jmgao/passinglink/README.md

Moved to [passinglink/passinglink](https://github.com/passinglink/passinglink)
