jmgao/passinglink/pcb/module/passinglink.kicad_pcb

## KiCad design pcb/module/passinglink.kicad_pcb (2019-11-01)

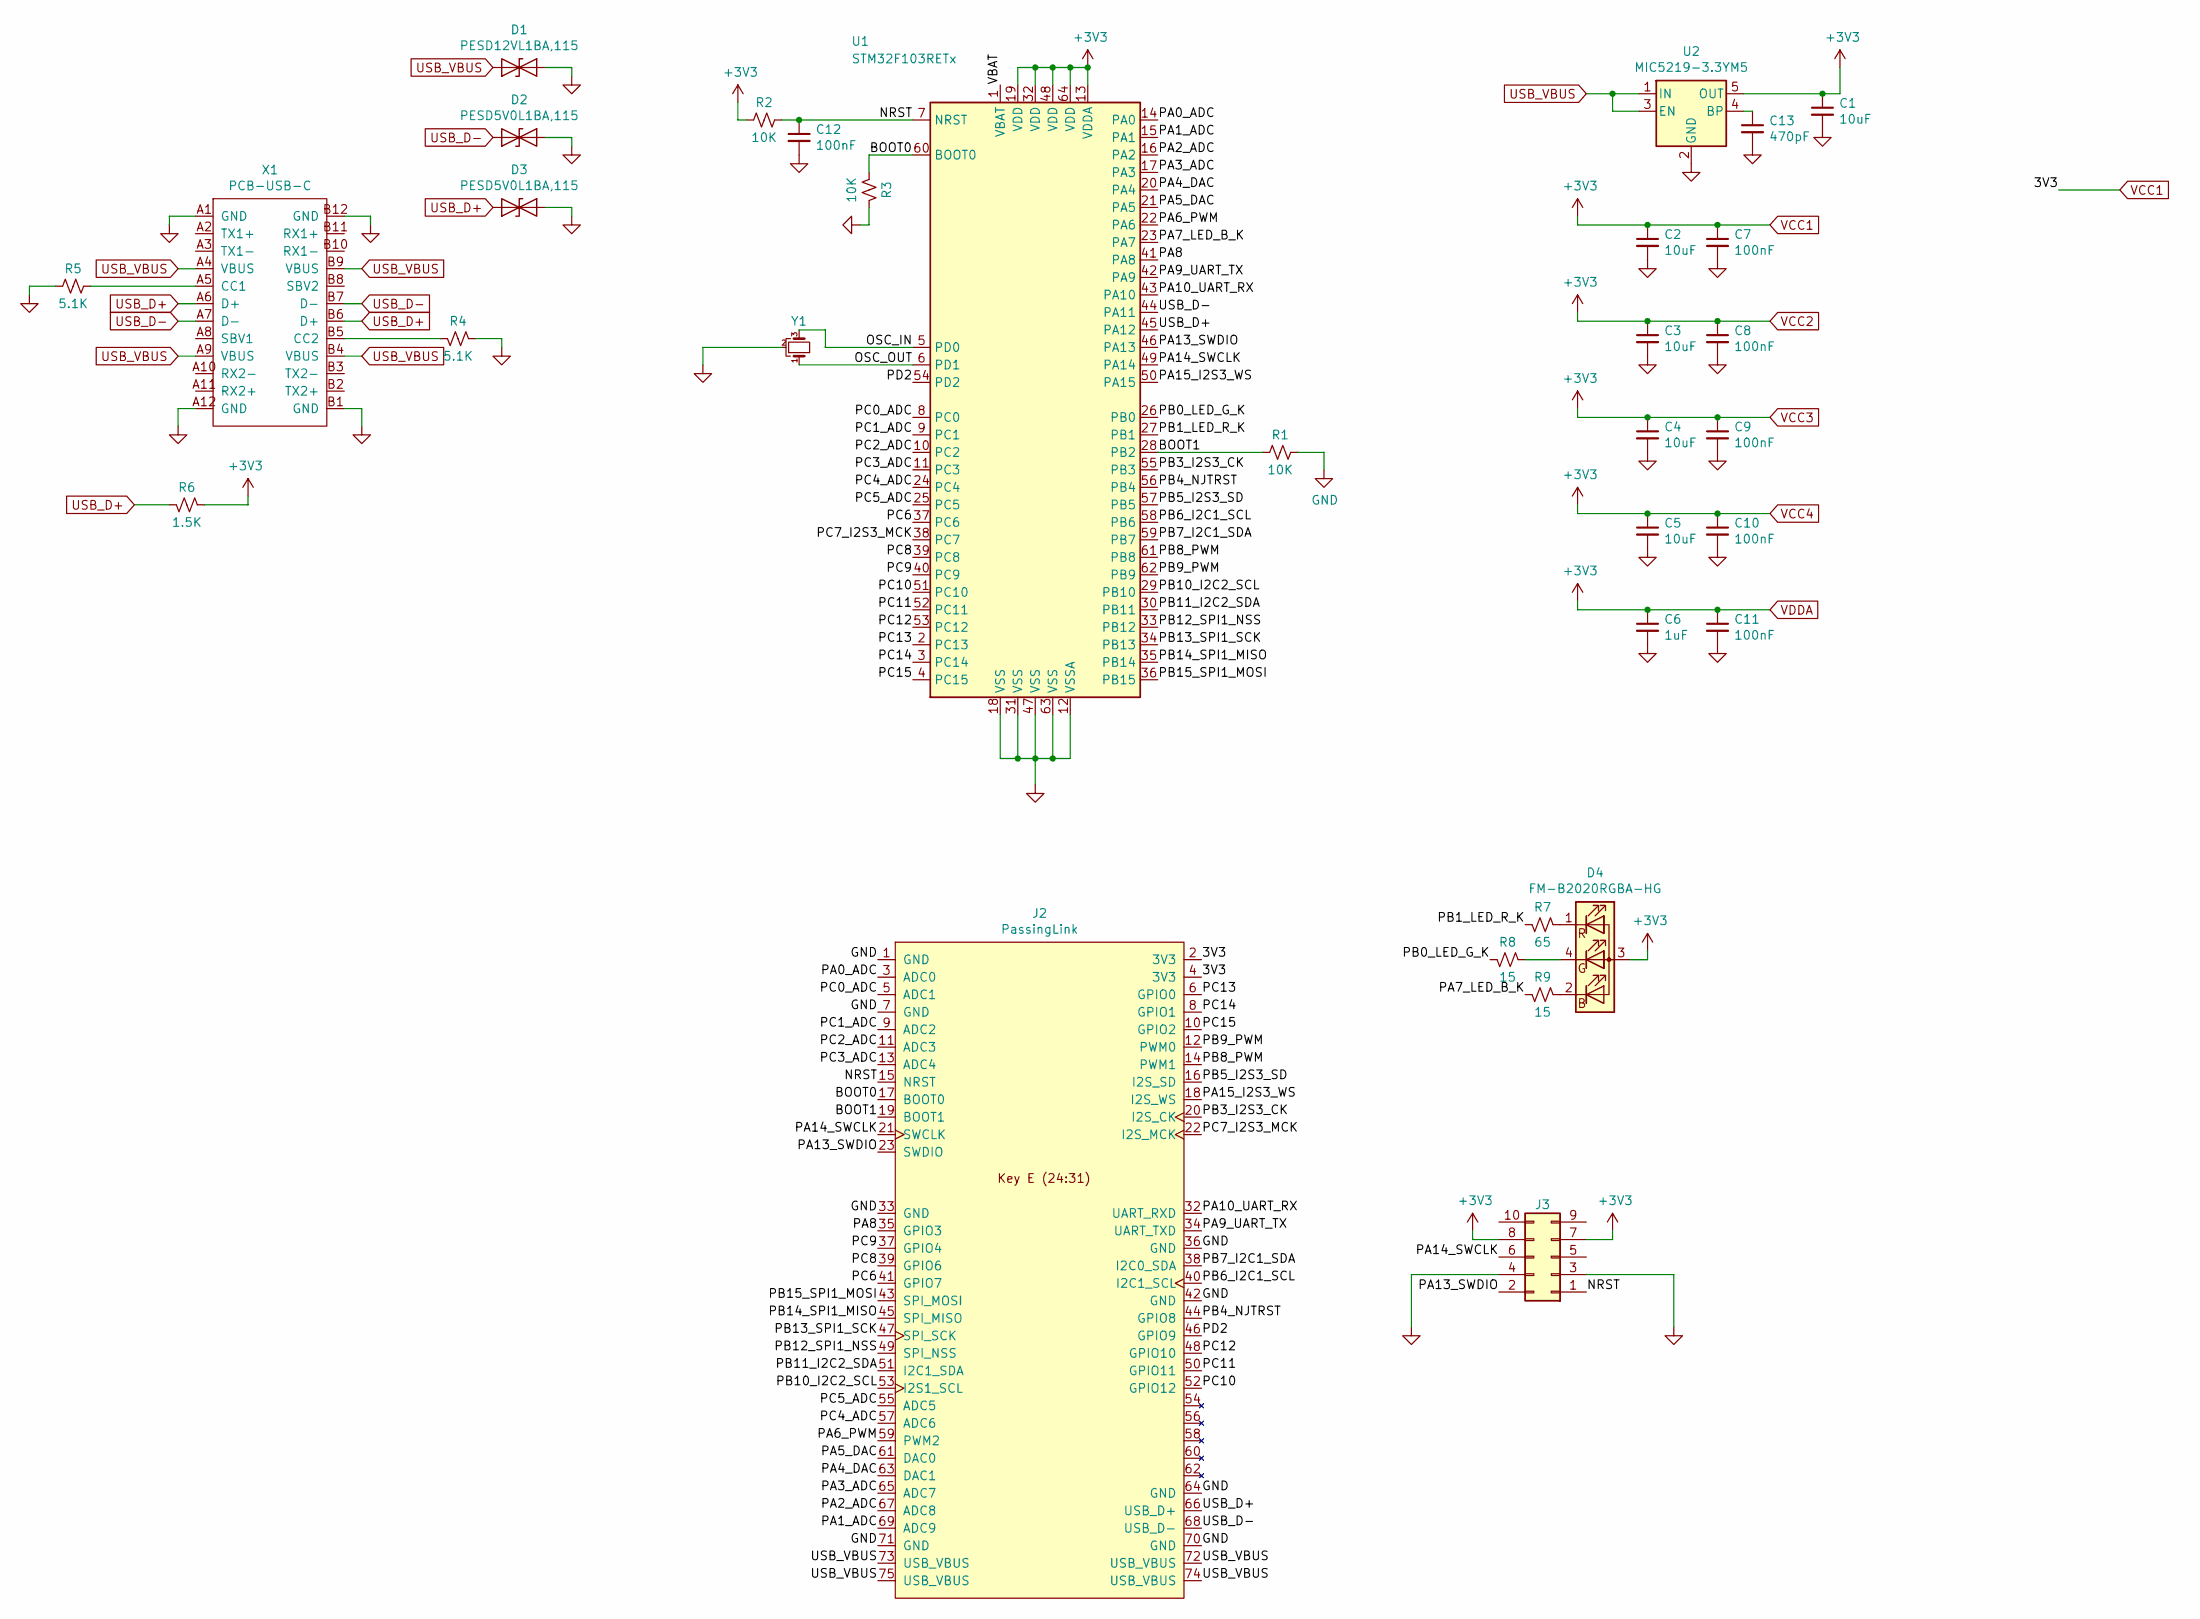
[picture p1: schematic passinglink.sch]

Parts:
C1, C2, C3, C4, C5: 10uF; C_0603_1608Metric
C6: 1uF; C_0603_1608Metric
C7, C8, C9, C10, C11, C12: 100nF; C_0603_1608Metric
C13: 470pF; C_0603_1608Metric
D1: PESD12VL1BA,115; D_SOD-323
D2, D3: PESD5V0L1BA,115; D_SOD-323
D4: FM-B2020RGBA-HG
J2: PassingLink; NGFF_E
J3: Conn_02x05_Odd_Even; Tag-Connect_TC2050-IDC-NL_2x05_P1.27mm_Vertical
R1, R2, R3: 10K; R_0603_1608Metric
R4, R5: 5.1K; R_0603_1608Metric
R6: 1.5K; R_0603_1608Metric
R7: 65; R_0603_1608Metric
R8, R9: 15; R_0603_1608Metric
U1: STM32F103RETx; LQFP-64_10x10mm_P0.5mm
U2: MIC5219-3.3YM5; SOT-23-5
X1: PCB-USB-C
Y1: Crystal_GND2_Small; Resonator_SMD_muRata_CSTxExxV-3Pin_3.0x1.1mm

Connections:
/BOOT0: J2.17 (BOOT0), R3.1, U1.60 (BOOT0)
/BOOT1: J2.19 (BOOT1), R1.2, U1.28 (PB2)
/NRST: C12.1, J2.15 (NRST), J3.1, R2.1, U1.7 (NRST)
/OSC_IN: U1.5 (PD0), Y1.3
/OSC_OUT: U1.6 (PD1), Y1.1
/PA0_ADC: J2.3 (ADC0), U1.14 (PA0)
/PA1_ADC: J2.69 (ADC9), U1.15 (PA1)
/PA2_ADC: J2.67 (ADC8), U1.16 (PA2)
/PA3_ADC: J2.65 (ADC7), U1.17 (PA3)
/PA4_DAC: J2.63 (DAC1), U1.20 (PA4)
/PA5_DAC: J2.61 (DAC0), U1.21 (PA5)
/PA6_PWM: J2.59 (PWM2), U1.22 (PA6)
/PA7_LED_B_K: R9.1, U1.23 (PA7)
/PA8: J2.35 (GPIO3), U1.41 (PA8)
/PA9_UART_TX: J2.34 (UART_TXD), U1.42 (PA9)
/PA10_UART_RX: J2.32 (UART_RXD), U1.43 (PA10)
/PA13_SWDIO: J2.23 (SWDIO), J3.2, U1.46 (PA13)
/PA14_SWCLK: J2.21 (SWCLK), J3.6, U1.49 (PA14)
/PA15_I2S3_WS: J2.18 (I2S_WS), U1.50 (PA15)
/PB0_LED_G_K: R8.1, U1.26 (PB0)
/PB1_LED_R_K: R7.1, U1.27 (PB1)
/PB3_I2S3_CK: J2.20 (I2S_CK), U1.55 (PB3)
/PB4_NJTRST: J2.44 (GPIO8), U1.56 (PB4)
/PB5_I2S3_SD: J2.16 (I2S_SD), U1.57 (PB5)
/PB6_I2C1_SCL: J2.40 (I2C1_SCL), U1.58 (PB6)
/PB7_I2C1_SDA: J2.38 (I2C0_SDA), U1.59 (PB7)
/PB8_PWM: J2.14 (PWM1), U1.61 (PB8)
/PB9_PWM: J2.12 (PWM0), U1.62 (PB9)
/PB10_I2C2_SCL: J2.53 (I2S1_SCL), U1.29 (PB10)
/PB11_I2C2_SDA: J2.51 (I2C1_SDA), U1.30 (PB11)
/PB12_SPI1_NSS: J2.49 (SPI_NSS), U1.33 (PB12)
/PB13_SPI1_SCK: J2.47 (SPI_SCK), U1.34 (PB13)
/PB14_SPI1_MISO: J2.45 (SPI_MISO), U1.35 (PB14)
/PB15_SPI1_MOSI: J2.43 (SPI_MOSI), U1.36 (PB15)
/PC0_ADC: J2.5 (ADC1), U1.8 (PC0)
/PC1_ADC: J2.9 (ADC2), U1.9 (PC1)
/PC2_ADC: J2.11 (ADC3), U1.10 (PC2)
/PC3_ADC: J2.13 (ADC4), U1.11 (PC3)
/PC4_ADC: J2.57 (ADC6), U1.24 (PC4)
/PC5_ADC: J2.55 (ADC5), U1.25 (PC5)
/PC6: J2.41 (GPIO7), U1.37 (PC6)
/PC7_I2S3_MCK: J2.22 (I2S_MCK), U1.38 (PC7)
/PC8: J2.39 (GPIO6), U1.39 (PC8)
/PC9: J2.37 (GPIO4), U1.40 (PC9)
/PC10: J2.52 (GPIO12), U1.51 (PC10)
/PC11: J2.50 (GPIO11), U1.52 (PC11)
/PC12: J2.48 (GPIO10), U1.53 (PC12)
/PC13: J2.6 (GPIO0), U1.2 (PC13)
/PC14: J2.8 (GPIO1), U1.3 (PC14)
/PC15: J2.10 (GPIO2), U1.4 (PC15)
/PD2: J2.46 (GPIO9), U1.54 (PD2)
/VBAT: U1.1 (VBAT)
GND: C1.2, C2.2, C3.2, C4.2, C5.2, C6.2, C7.2, C8.2, C9.2, C10.2, C11.2, C12.2, C13.2, D1.2 (A2), D2.2 (A2), D3.2 (A2), J2.1 (GND), J2.7 (GND), J2.33 (GND), J2.36 (GND), J2.42 (GND), J2.64 (GND), J2.70 (GND), J2.71 (GND), J3.3, J3.4, R1.1, R3.2, R4.2, R5.2, U1.12 (VSSA), U1.18 (VSS), U1.31 (VSS), U1.47 (VSS), U1.63 (VSS), U2.2 (GND), X1.A1 (GND), X1.A12 (GND), X1.B1 (GND), X1.B12 (GND), Y1.2
unnamed: C13.1, U2.4 (BP)
unnamed: D4.1 (R-), R7.2
unnamed: D4.2 (B-), R9.2
unnamed: D4.4 (G-), R8.2
unnamed: R4.1, X1.B5 (CC2)
unnamed: R5.1, X1.A5 (CC1)
USB_D+: D3.1 (A1), J2.66 (USB_D+), R6.1, U1.45 (PA12), X1.A6 (D+), X1.B6 (D+)
USB_D-: D2.1 (A1), J2.68 (USB_D-), U1.44 (PA11), X1.A7 (D-), X1.B7 (D-)
USB_VBUS: D1.1 (A1), J2.72 (USB_VBUS), J2.73 (USB_VBUS), J2.74 (USB_VBUS), J2.75 (USB_VBUS), U2.1 (IN), U2.3 (EN), X1.A4 (VBUS), X1.A9 (VBUS), X1.B4 (VBUS), X1.B9 (VBUS)
VCC1: C1.1, C2.1, C3.1, C4.1, C5.1, C6.1, C7.1, C8.1, C9.1, C10.1, C11.1, D4.3 (+), J2.2 (3V3), J2.4 (3V3), J3.7, J3.8, R2.2, R6.2, U1.13 (VDDA), U1.19 (VDD), U1.32 (VDD), U1.48 (VDD), U1.64 (VDD), U2.5 (OUT)

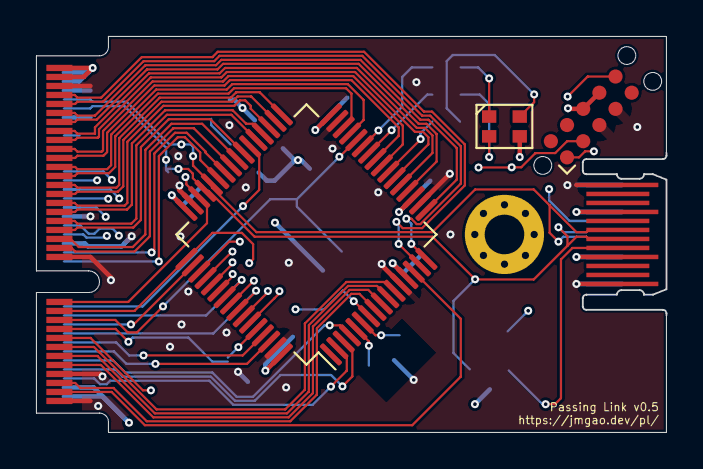
[picture p2: board pcb/module/passinglink.kicad_pcb from above]

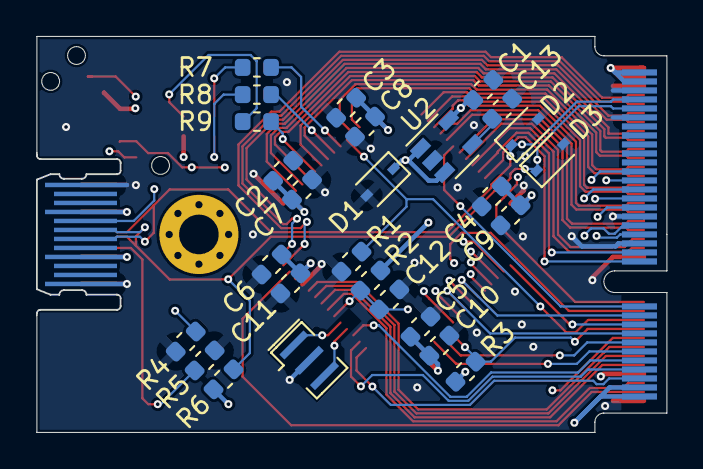
[picture p3: board pcb/module/passinglink.kicad_pcb from below]

Board: 4 copper layers, 35.0 x 22.0 mm, 33 parts (27 on the bottom side), 62 nets.

Other parts of the board:
H1: MountingHole_2.2mm_M2_Pad_Via
