jmgao/passinglink/pcb/adapter/panthera/passinglink.kicad_pcb

## KiCad design pcb/adapter/panthera/passinglink.kicad_pcb (2019-08-26)

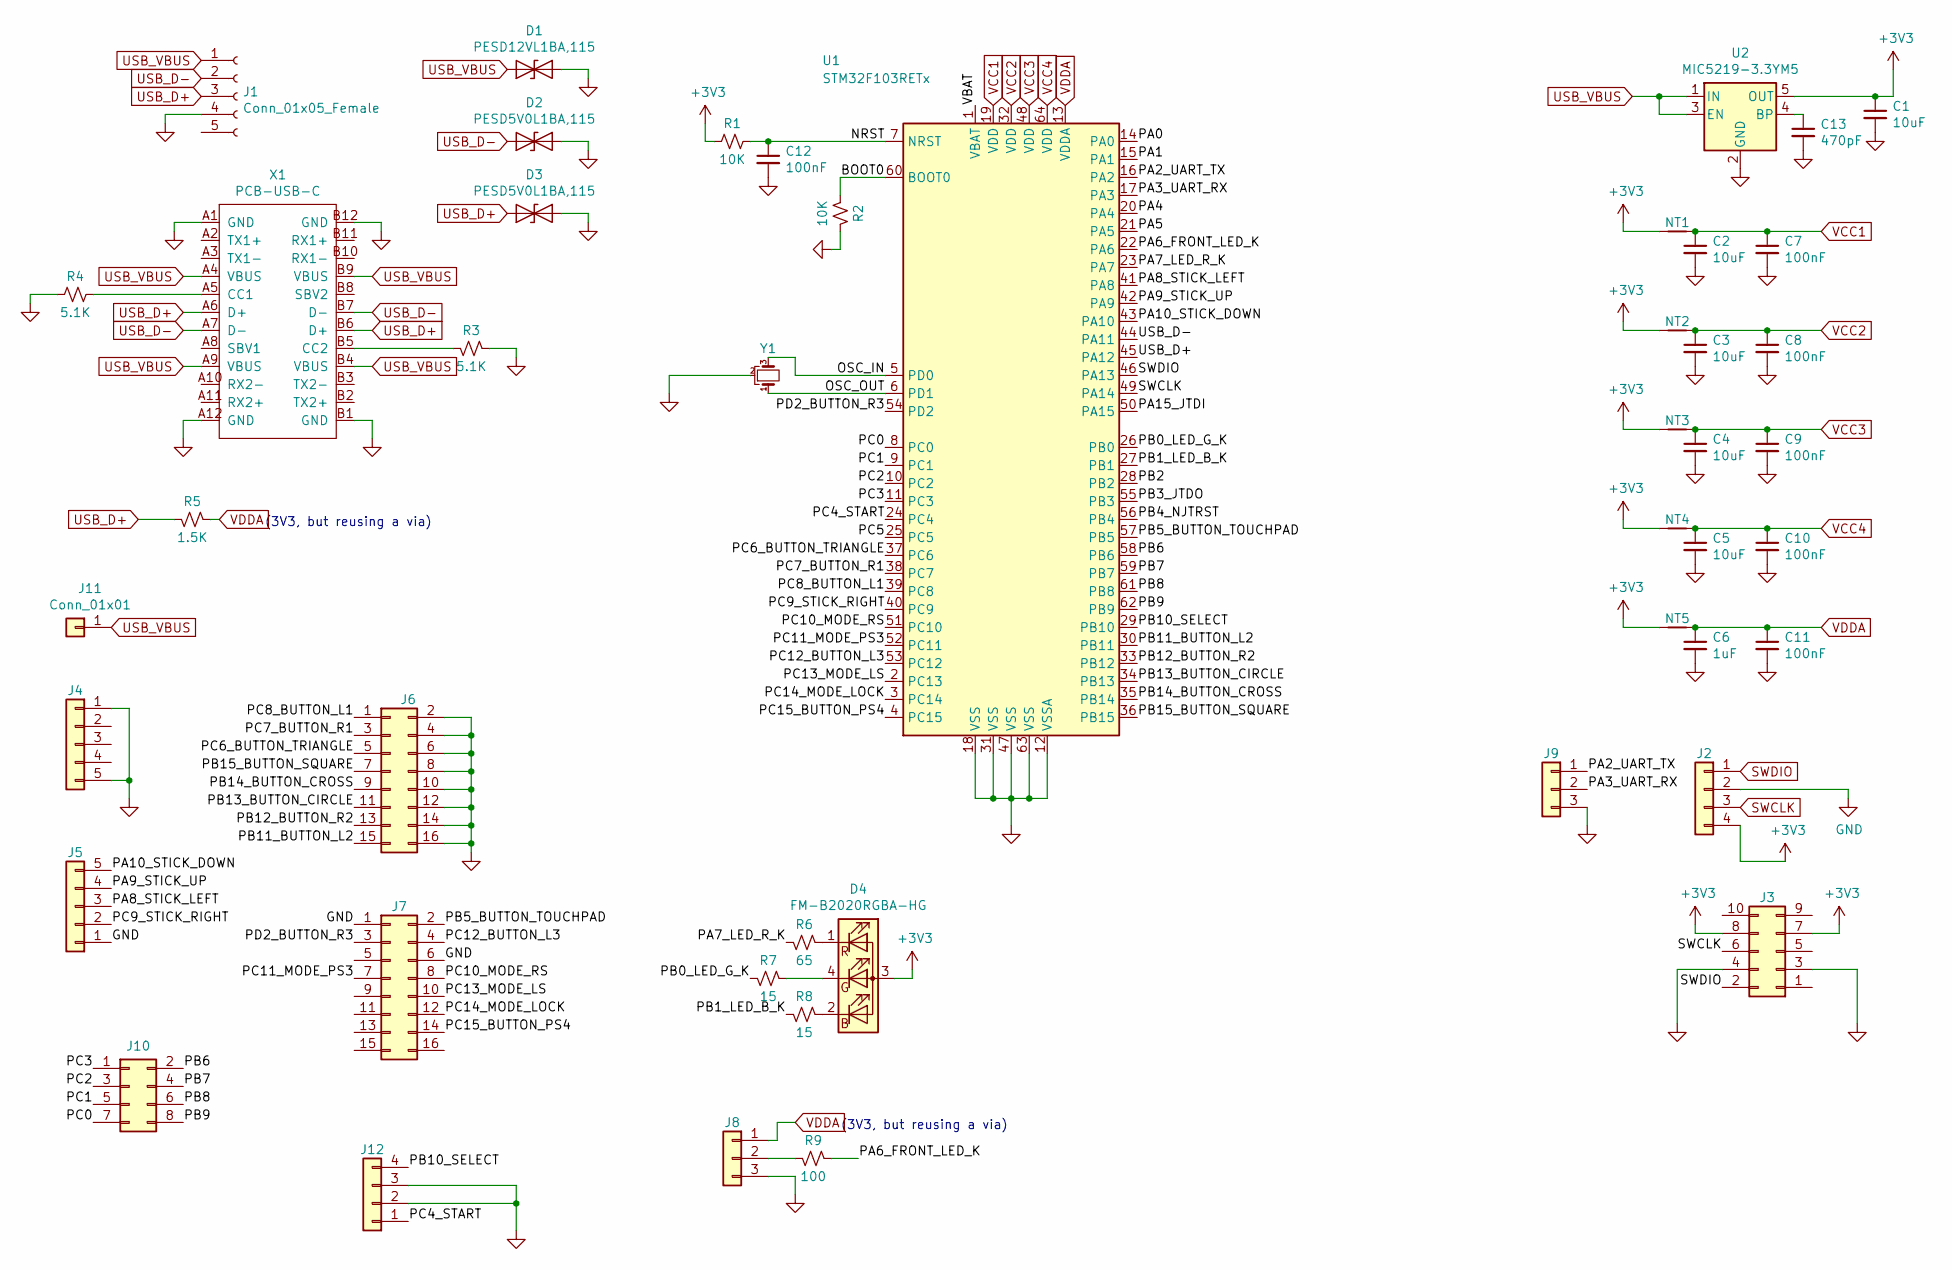
[picture p4: schematic passinglink.sch]

Parts:
C1, C2, C3, C4, C5: 10uF; C_0603_1608Metric
C6: 1uF; C_0603_1608Metric
C7, C8, C9, C10, C11, C12: 100nF; C_0603_1608Metric
C13: 470pF; C_0603_1608Metric
D1: PESD12VL1BA,115; D_SOD-323
D2, D3: PESD5V0L1BA,115; D_SOD-323
D4: FM-B2020RGBA-HG
J1: Conn_01x05_Female; JST_XH_B5B-XH-A_1x05_P2.50mm_Vertical
J2: Conn_01x04; PinHeader_1x04_P2.54mm_Vertical
J3: Conn_02x05_Odd_Even; Tag-Connect_TC2050-IDC-NL_2x05_P1.27mm_Vertical
J4, J5: Conn_01x05; JST_XH_B5B-XH-A_1x05_P2.50mm_Vertical
J6, J7: Conn_02x08_Odd_Even; PinHeader_2x08_P2.54mm_Vertical
J8, J9: Conn_01x03; JST_XH_B3B-XH-A_1x03_P2.50mm_Vertical
J10: Conn_02x04_Odd_Even; PinHeader_2x04_P1.27mm_Vertical
J11: Conn_01x01; PinHeader_1x01_P2.54mm_Vertical
J12: Conn_01x04; JST_XH_B4B-XH-A_1x04_P2.50mm_Vertical
NT1, NT2, NT3, NT4, NT5: Net-Tie_2; NetTie-2_SMD_Pad0.5mm
R1, R2: 10K; R_0603_1608Metric
R3, R4: 5.1K; R_0603_1608Metric
R5: 1.5K; R_0603_1608Metric
R6: 65; R_0603_1608Metric
R7, R8: 15; R_0603_1608Metric
R9: 100; R_0603_1608Metric
U1: STM32F103RETx; LQFP-64_10x10mm_P0.5mm
U2: MIC5219-3.3YM5; SOT-23-5
X1: PCB-USB-C
Y1: Crystal_GND2_Small; Resonator_SMD_muRata_CSTxExxV-3Pin_3.0x1.1mm

Connections:
+3V3: C1.1, D4.3 (+), J2.4, J3.7, J3.8, NT1.1, NT2.1, NT3.1, NT4.1, NT5.1, R1.2, U2.5 (OUT)
/BOOT0: R2.1, U1.60 (BOOT0)
/NRST: C12.1, R1.1, U1.7 (NRST)
/OSC_IN: U1.5 (PD0), Y1.3
/OSC_OUT: U1.6 (PD1), Y1.1
/PA0: U1.14 (PA0)
/PA1: U1.15 (PA1)
/PA2_UART_TX: J9.1, U1.16 (PA2)
/PA3_UART_RX: J9.2, U1.17 (PA3)
/PA4: U1.20 (PA4)
/PA5: U1.21 (PA5)
/PA6_FRONT_LED_K: R9.2, U1.22 (PA6)
/PA7_LED_R_K: R6.1, U1.23 (PA7)
/PA8_STICK_LEFT: J5.3, U1.41 (PA8)
/PA9_STICK_UP: J5.4, U1.42 (PA9)
/PA10_STICK_DOWN: J5.5, U1.43 (PA10)
/PA15_JTDI: U1.50 (PA15)
/PB0_LED_G_K: R7.1, U1.26 (PB0)
/PB1_LED_B_K: R8.1, U1.27 (PB1)
/PB2: U1.28 (PB2)
/PB3_JTDO: U1.55 (PB3)
/PB4_NJTRST: U1.56 (PB4)
/PB5_BUTTON_TOUCHPAD: J7.2, U1.57 (PB5)
/PB6: J10.2, U1.58 (PB6)
/PB7: J10.4, U1.59 (PB7)
/PB8: J10.6, U1.61 (PB8)
/PB9: J10.8, U1.62 (PB9)
/PB10_SELECT: J12.4, U1.29 (PB10)
/PB11_BUTTON_L2: J6.15, U1.30 (PB11)
/PB12_BUTTON_R2: J6.13, U1.33 (PB12)
/PB13_BUTTON_CIRCLE: J6.11, U1.34 (PB13)
/PB14_BUTTON_CROSS: J6.9, U1.35 (PB14)
/PB15_BUTTON_SQUARE: J6.7, U1.36 (PB15)
/PC0: J10.7, U1.8 (PC0)
/PC1: J10.5, U1.9 (PC1)
/PC2: J10.3, U1.10 (PC2)
/PC3: J10.1, U1.11 (PC3)
/PC4_START: J12.1, U1.24 (PC4)
/PC5: U1.25 (PC5)
/PC6_BUTTON_TRIANGLE: J6.5, U1.37 (PC6)
/PC7_BUTTON_R1: J6.3, U1.38 (PC7)
/PC8_BUTTON_L1: J6.1, U1.39 (PC8)
/PC9_STICK_RIGHT: J5.2, U1.40 (PC9)
/PC10_MODE_RS: J7.8, U1.51 (PC10)
/PC11_MODE_PS3: J7.7, U1.52 (PC11)
/PC12_BUTTON_L3: J7.4, U1.53 (PC12)
/PC13_MODE_LS: J7.10, U1.2 (PC13)
/PC14_MODE_LOCK: J7.12, U1.3 (PC14)
/PC15_BUTTON_PS4: J7.14, U1.4 (PC15)
/PD2_BUTTON_R3: J7.3, U1.54 (PD2)
/VBAT: U1.1 (VBAT)
GND: C1.2, C2.2, C3.2, C4.2, C5.2, C6.2, C7.2, C8.2, C9.2, C10.2, C11.2, C12.2, C13.2, D1.2 (A2), D2.2 (A2), D3.2 (A2), J1.4, J2.2, J3.3, J3.4, J4.1, J4.5, J5.1, J6.2, J6.4, J6.6, J6.8, J6.10, J6.12, J6.14, J6.16, J7.1, J7.6, J8.3, J9.3, J12.2, J12.3, R2.2, R3.2, R4.2, U1.12 (VSSA), U1.18 (VSS), U1.31 (VSS), U1.47 (VSS), U1.63 (VSS), U2.2 (GND), X1.A1 (GND), X1.A12 (GND), X1.B1 (GND), X1.B12 (GND), Y1.2
unnamed: C13.1, U2.4 (BP)
unnamed: D4.1 (R-), R6.2
unnamed: D4.2 (B-), R8.2
unnamed: D4.4 (G-), R7.2
unnamed: J8.2, R9.1
unnamed: R3.1, X1.B5 (CC2)
unnamed: R4.1, X1.A5 (CC1)
SWCLK: J2.3, J3.6, U1.49 (PA14)
SWDIO: J2.1, J3.2, U1.46 (PA13)
USB_D+: D3.1 (A1), J1.3, R5.1, U1.45 (PA12), X1.A6 (D+), X1.B6 (D+)
USB_D-: D2.1 (A1), J1.2, U1.44 (PA11), X1.A7 (D-), X1.B7 (D-)
USB_VBUS: D1.1 (A1), J1.1, J11.1, U2.1 (IN), U2.3 (EN), X1.A4 (VBUS), X1.A9 (VBUS), X1.B4 (VBUS), X1.B9 (VBUS)
VCC1: C2.1, C7.1, NT1.2, U1.19 (VDD)
VCC2: C3.1, C8.1, NT2.2, U1.32 (VDD)
VCC3: C4.1, C9.1, NT3.2, U1.48 (VDD)
VCC4: C5.1, C10.1, NT4.2, U1.64 (VDD)
VDDA: C6.1, C11.1, J8.1, NT5.2, R5.2, U1.13 (VDDA)

Notes on the sheet:
(3V3, but reusing a via)

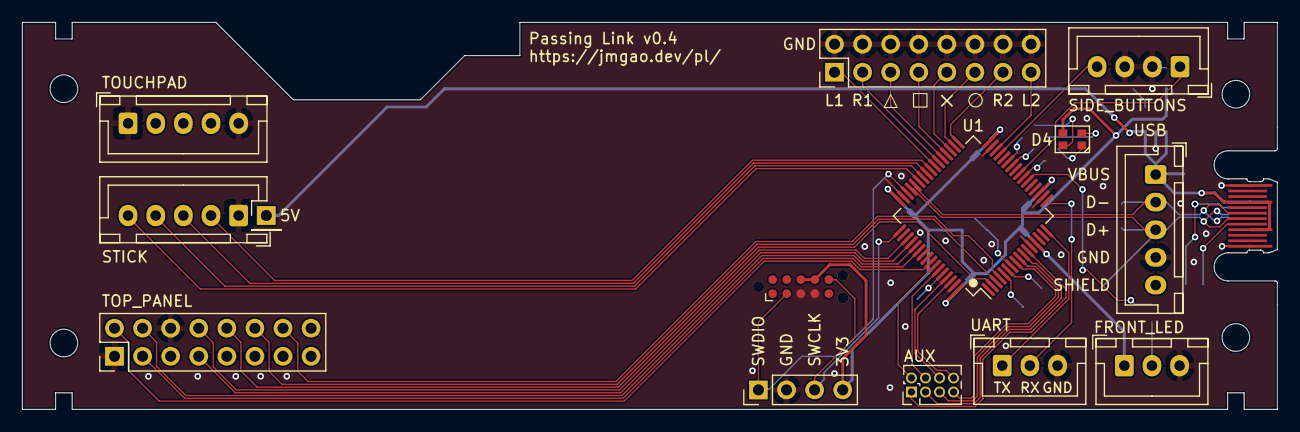
[picture p5: board pcb/adapter/panthera/passinglink.kicad_pcb from above]

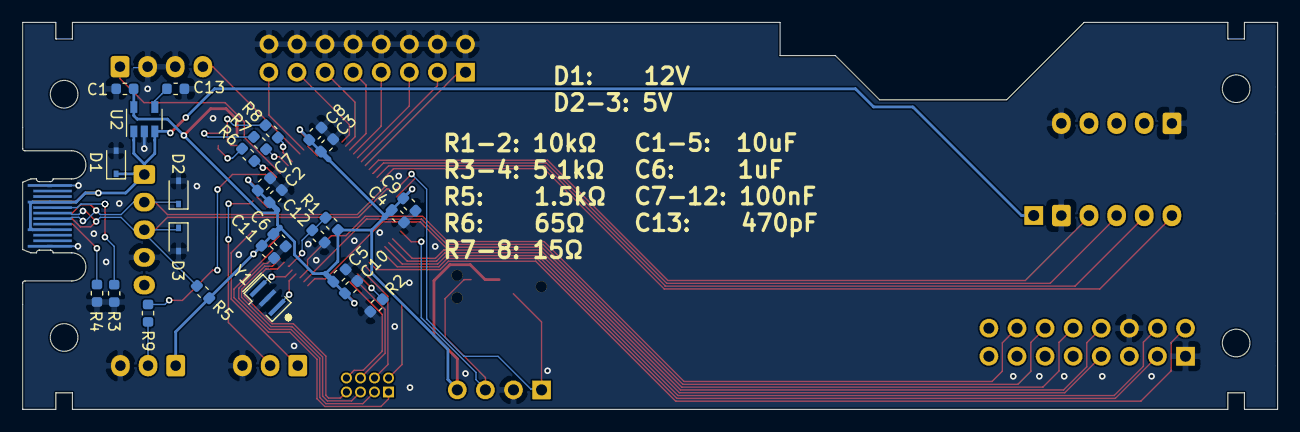
[picture p6: board pcb/adapter/panthera/passinglink.kicad_pcb from below]

Board: 2 copper layers, 113.5 x 35.0 mm, 47 parts (32 on the bottom side), 59 nets.
