jmgao/passinglink/(commit log)

2019-06-10 Replace empty idle loop with a nop.
    LLVM defines an infinite loop with no side effects as undefined
    behavior, which leads to a crash when compiled in release mode.
    [main.rs]
2019-06-10 Switch linker script to use 64kB of flash.
2019-06-11 Update stm32f1xx-hal.
2019-06-13 Implement PS4 HID emulation.
    This doesn't actually implement the PS4's controller authentication,
    which requires an actual private key to be dumped from a controller, but
    it's good enough to work for 10 minutes at a time.
    [input.rs, main.rs, mod.rs]
2019-07-10 Switch to stm32-usbd.
2019-07-25 Wire up inputs.
2019-07-26 Update stm32-usbd version.
2019-07-26 Remove LED for now.
2019-07-26 Fix initial timer tick value.
    [main.rs]
2019-07-26 Schedule timers in idle.
    It appears that a bug in RTFM (japaric/cortex-m-rtfm#196) results in
    tasks scheduled from init to be delayed by ~10 seconds. Move scheduling
    to the top of the idle task to work around this.
    [main.rs]
2019-08-08 Unvendor stm32f103xx-usb.
    Upstream is deprecated in favor of stm32-usbd, and we've switched
    over already.
2019-08-08 Pin specific version of crc.
2019-08-08 Merge upstream into vendored stm32f1xx-hal.
    Also silence warnings.
2019-08-08 Switch back to upstream usb-device.
2019-08-08 Gracefully handle missing keys.
    [auth.rs]
2019-08-08 Add support for lock switch.
2019-08-08 Set trigger analog values along with buttons.
2019-08-26 PCB revision v0.4.
    [passinglink.kicad_pcb, passinglink.sch]
2019-08-26 Extract pin assignment, add support for PCB v0.4.
2019-08-27 Revert "Massively overprovision the allocator."
    This reverts commit 47312898e7972ae071ea3d45f2e46ec44b8c04de.
    [allocator.rs]
2019-08-29 Implement LS/DPad mode switch.
2019-08-30 Improve handling of invalid auth state transitions.
    It seems that on occasion, we will get seemingly invalid auth packets
    (e.g. getting a new nonce before we've sent out the full signature),
    which can result in auth hanging and us getting kicked off after 10
    minutes. This can also happen when disconnecting and reconnecting while
    externally powered.
2019-08-30 Delete dead asm!("nop") loop.
    Infinite loops without side effects are undefined behavior in LLVM, so
    previously, we needed an explicit nop to avoid the loop getting deleted
    and our idle task falling through to whatever was below. We now have a
    loop with side effects that can't get optimized out, so the loop is now
    dead code.
    [auth.rs]
2019-08-30 Block interrupts in alloc/dealloc.
    There seem to be OOMs happening despite the high water mark being lower
    than the actual number of blocks available. One possible explanation
    would be reentrancy in alloc, so let's rule that out first.
2019-09-03 Vendor stm32-usbd.
2019-09-03 Update stm32f1xx-hal version.
2019-09-05 Turn off LEDs on start.
2019-10-18 Import NGFF footprint library.
2019-10-18 Prepare to split the PCB into two parts.
    [passinglink.kicad_pcb, passinglink.sch]
2019-10-18 Create symbol for the M.2 connector.
2019-11-01 PCB v0.5.
    Layout a new PCB that connects to an external breakout board via an M.2
    connector.
    [passinglink.kicad_pcb, passinglink.sch]
